drewnotdrew/digital-gate-driver/documentation/images/2025-04-20_17-02.png

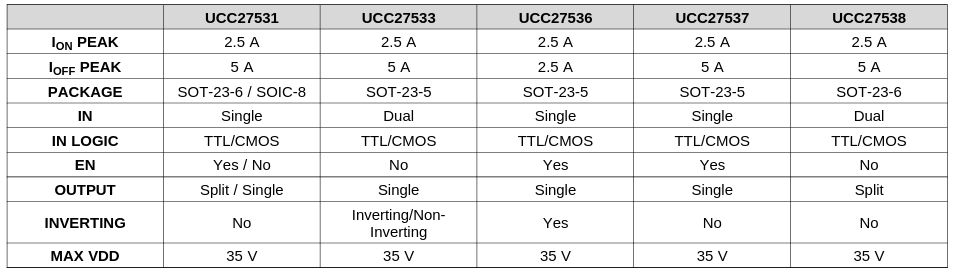
documentation/images/2025-04-20_17-02.png
