drewnotdrew/digital-gate-driver/documentation/images/2025-04-20_17-09.png

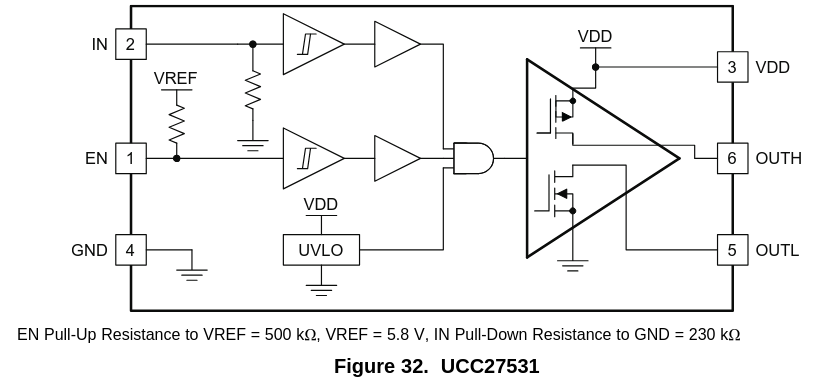
documentation/images/2025-04-20_17-09.png
