drewnotdrew/digital-gate-driver/documentation/images/digital-gate-driver-block-diagram.png

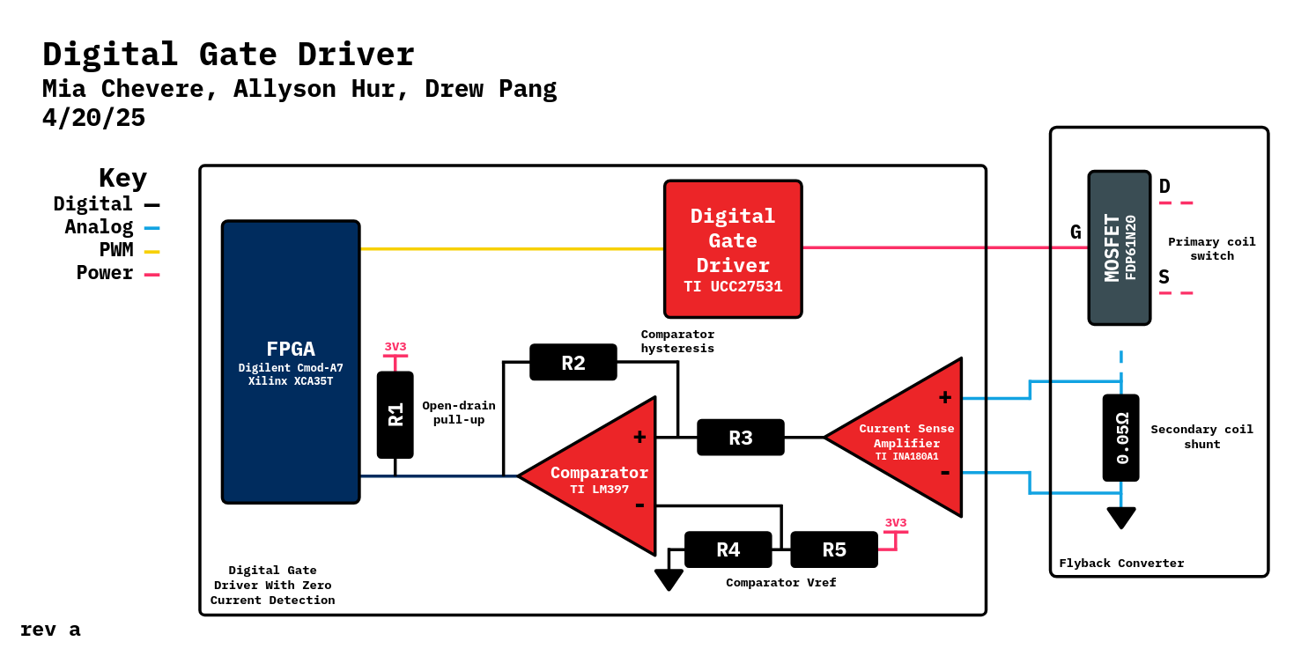
documentation/images/digital-gate-driver-block-diagram.png
