drewnotdrew/digital-gate-driver/pcb/digital_gate_driver.dxf

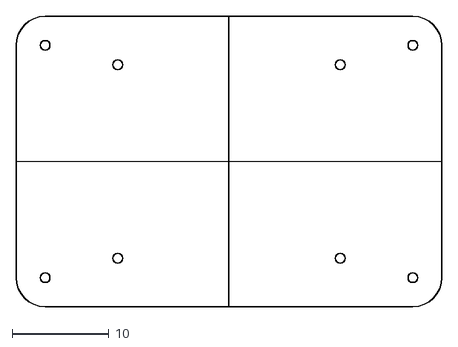
[picture p7: CAD file, 2025-04-23]
pcb/digital_gate_driver.dxf
44.0 x 30.0
