drewnotdrew/digital-gate-driver/pcb/digital-gate-driver.pdf

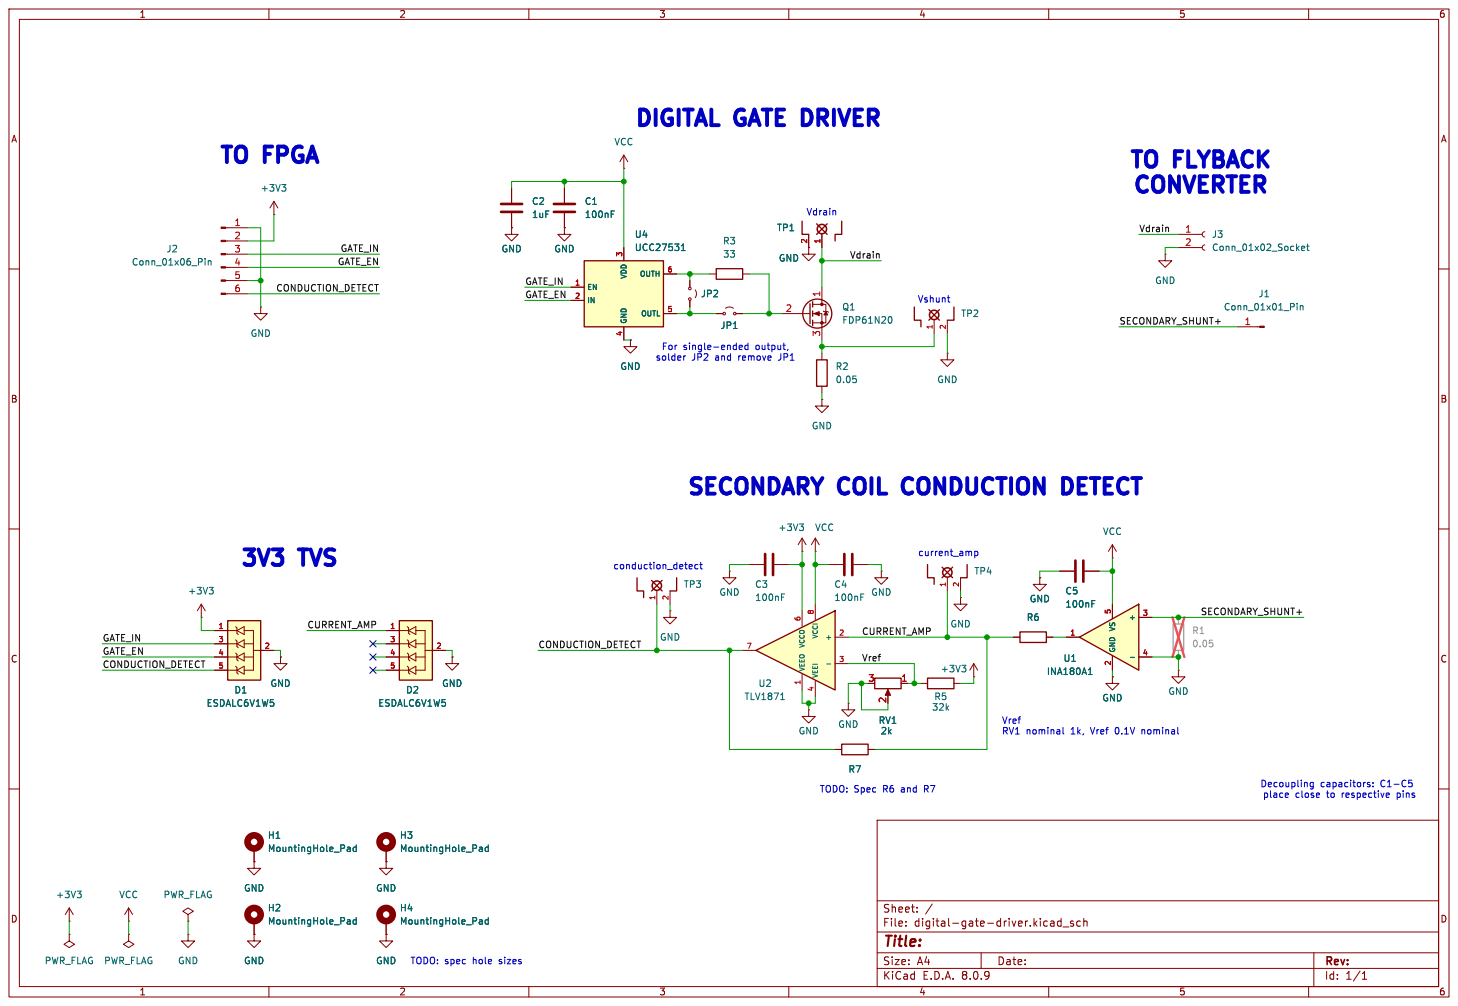
[picture p8: page 1]

4 OUTL 5 OUTH 6 U4 UCC27531 GND GND

4 OUTL 5 OUTH 6 GND GND
