drewnotdrew/digital-gate-driver/pcb/digital-gate-driver.kicad_pcb

## KiCad design pcb/digital-gate-driver.kicad_pcb (2025-04-23)

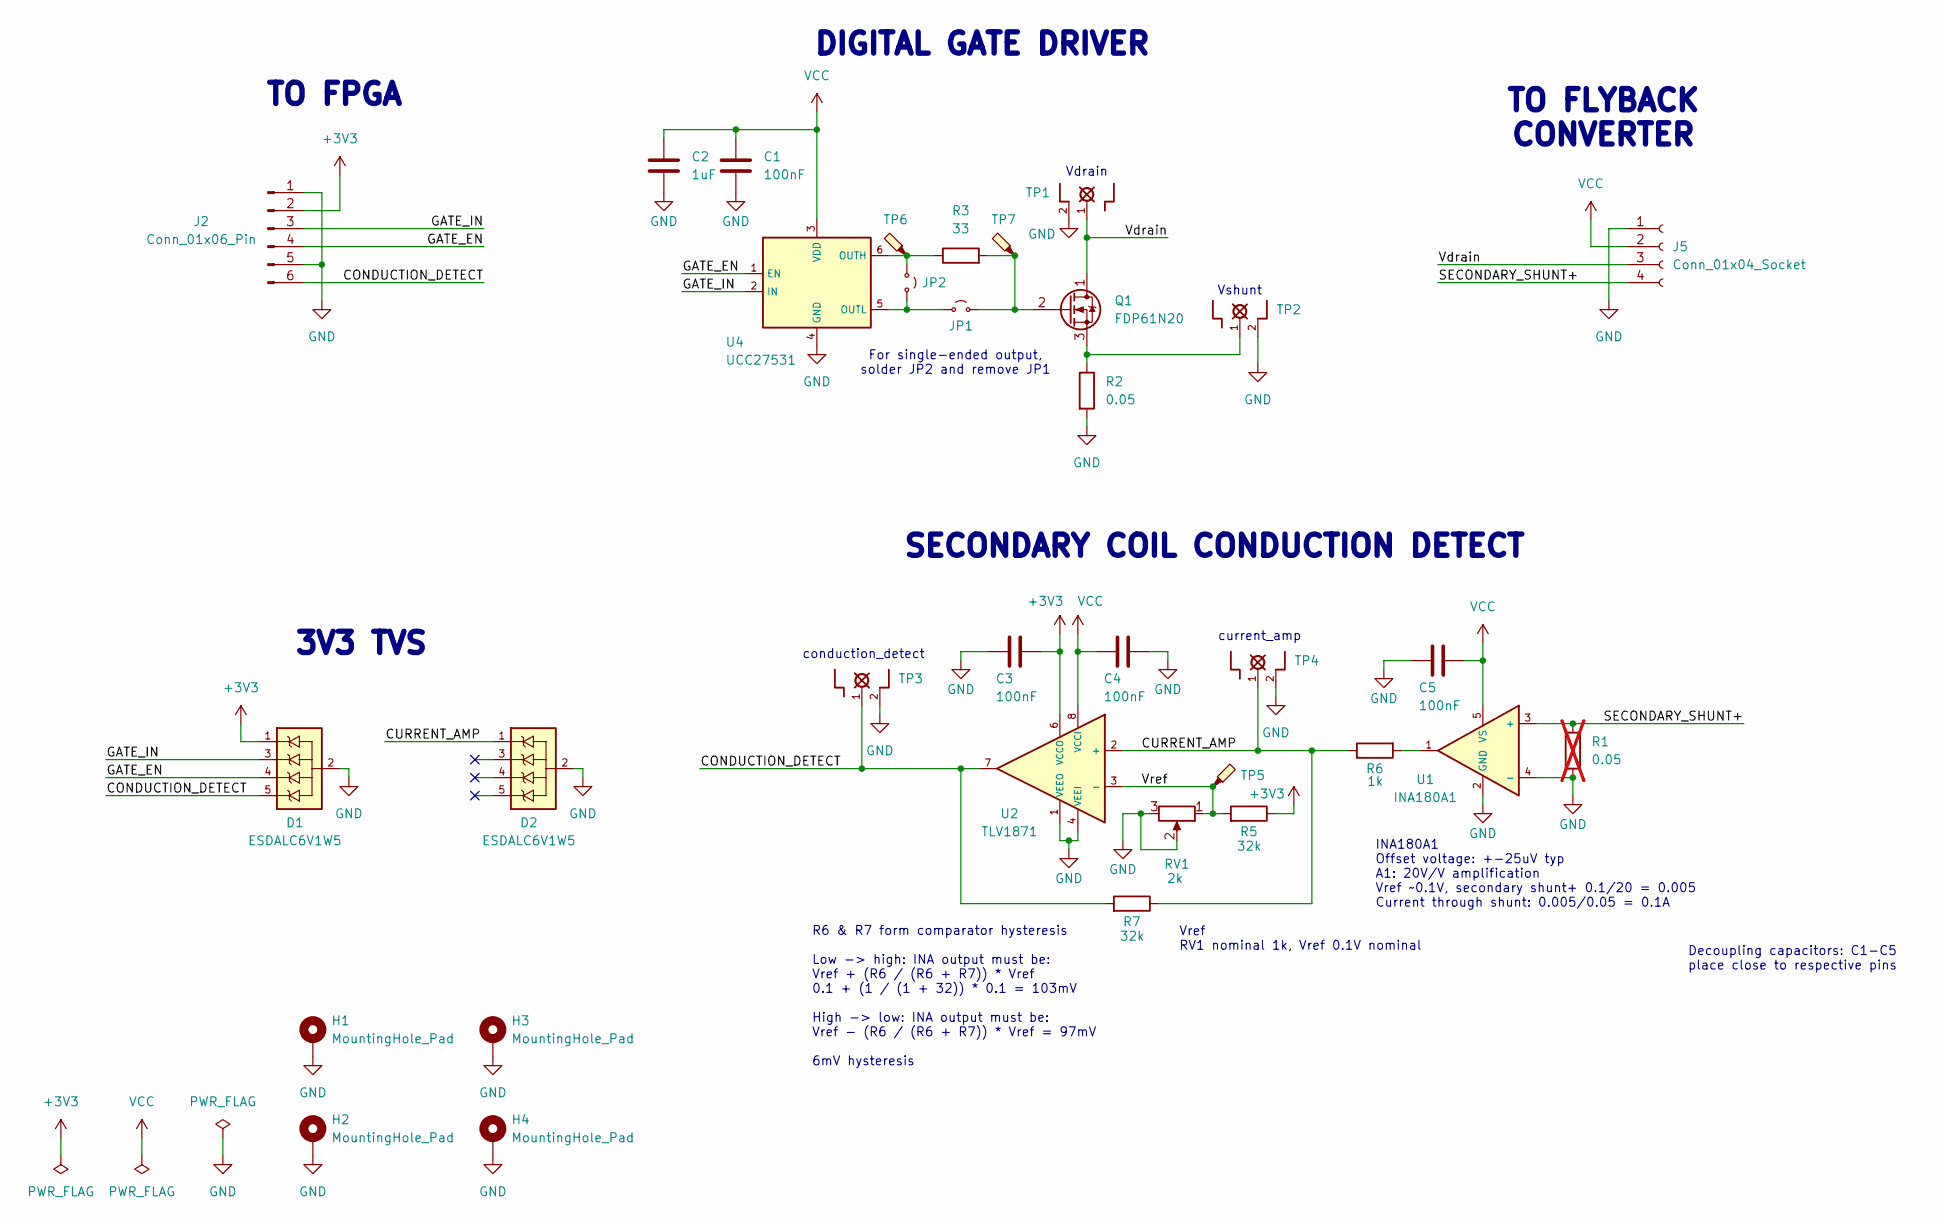
[picture p9: schematic digital-gate-driver.kicad_sch]

Parts:
C1, C3, C4, C5: 100nF; C_0603_1608Metric
C2: 1uF; C_0603_1608Metric
D1, D2: ESDALC6V1W5; MPN ESDALC6V1W5
H1, H2, H3, H4: MountingHole_Pad; MountingHole_2.5mm_Pad_Via
J2: Conn_01x06_Pin; PinHeader_1x06_P2.54mm_Vertical
J5: Conn_01x04_Socket; MOLEX_436500418
JP1, JP2: Jumper_2_Small_Open; SolderJumper-2_Open_Hooks0.8x1.8mm
Q1: FDP61N20; MPN FDP61N20
R1: 0.05; R_1206_3216Metric; not fitted
R2: 0.05; R_1206_3216Metric
R3: 33; THT_SOCKET_RESISTOR
R5, R7: 32k; R_0603_1608Metric
R6: 1k; R_0603_1608Metric
RV1: 2k; PV36W201C01B00
TP1, TP2, TP3, TP4: TP_SCOPE
TP5, TP6, TP7: TestPoint_Probe; TP_SMD
U1: INA180A1; INA180A1IDBVR; MPN INA180A1IDBVR
U2: TLV1871; TLV1871DDFR; MPN TLV1871DDFR
U4: UCC27531; UCC2753DBVT; MPN UCC27531DBVR

Connections:
+3V3: C3.2, D1.1, J2.2, R5.1, U2.6 (VCCO)
/CONDUCTION_DETECT: D1.5, J2.6, R7.2, TP3.1, U2.7
/CURRENT_AMP: D2.1, R6.1, R7.1, TP4.1, U2.2 (+)
/GATE_EN: D1.4, J2.4, U4.1 (EN)
/GATE_IN: D1.3, J2.3, U4.2 (IN)
/SECONDARY_SHUNT+: J5.4, R1.1, U1.3 (+)
/Vdrain: J5.3, Q1.1 (D), TP1.1
/Vref: R5.2, RV1.1, TP5.1, U2.3 (-)
GND: C1.2, C2.2, C3.1, C4.2, C5.1, D1.2, D2.2, H1.1, H2.1, H3.1, H4.1, J2.1, J2.5, J5.1, R1.2, R2.2, RV1.2, RV1.3, TP1.2, TP2.2, TP3.2, TP4.2, U1.2 (GND), U1.4 (-), U2.1 (VEEO), U2.4 (VEEI), U4.4 (GND)
unnamed: JP1.1 (A), JP2.2 (B), U4.5 (OUTL)
unnamed: JP1.2 (B), Q1.2 (G), R3.2, TP7.1
unnamed: JP2.1 (A), R3.1, TP6.1, U4.6 (OUTH)
unnamed: Q1.3 (S), R2.1, TP2.1
unnamed: R6.2, U1.1
VCC: C1.1, C2.1, C4.1, C5.2, J5.2, U1.5 (VS), U2.8 (VCCI), U4.3 (VDD)

Notes on the sheet:
conduction_detect
Decoupling capacitors: C1-C5 place close to respective pins
TO FLYBACK CONVERTER
3V3 TVS
For single-ended output, solder JP2 and remove JP1
DIGITAL GATE DRIVER
INA180A1 Offset voltage: +-25uV typ A1: 20V/V amplification Vref ~0.1V, secondary shunt+ 0.1/20 = 0.005 Current through shunt: 0.005/0.05 = 0.1A
Vref RV1 nominal 1k, Vref 0.1V nominal
Vshunt
R6 & R7 form comparator hysteresis Low -> high: INA output must be: Vref + (R6 / (R6 + R7)) * Vref 0.1 + (1 / (1 + 32)) * 0.1 = 103mV High -> low: INA output must be: Vref - (R6 / (R6 + R7)) * Vref = 97mV 6mV hysteresis
SECONDARY COIL CONDUCTION DETECT
current_amp
Vdrain
TO FPGA

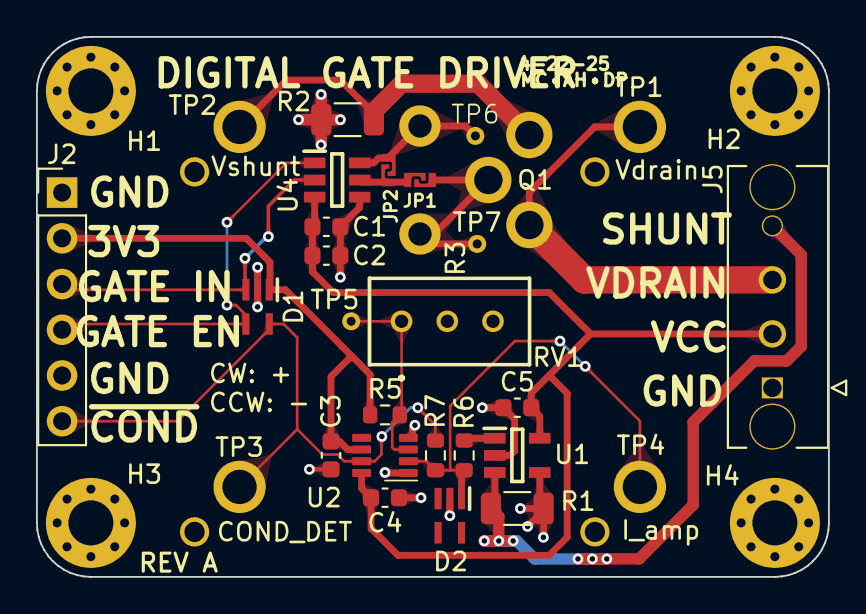
[picture p10: board digital-gate-driver.kicad_pcb from above]

Board: 2 copper layers, 44.0 x 30.0 mm, 33 parts (0 on the bottom side), 15 nets.
