drewnotdrew/digital-gate-driver/fpga/hdl/interfaces/uart/uart.sv

/*
Full-duplex uart interface with parameterized synchronization and oversampling.

The input synchronizer and oversampling form the input buffer, which directly
samples rx. The rx buffer is filled using majority voting based on the
oversampling poriton of the input buffer.

The input buffer is centered, meaning that the halfway through a UART bit the
input buffer is half full.

@param BUFFER_WIDTH: The number of data bits in a transmission
@param BAUD_RATE: The number of bits per second
@param CLK_FREQ: The input module clock frequency
@param SYNC_DEPTH: The depth of the input syncronyizer
@param OVERSAMPLING_DEPTH: The number of samples to take for each bit. Care must be
  taken to ensure the amount of oversampling does conflict with the baud rate.

*/

`begin_keywords "1800-2017"  // Use SystemVerilog 2017 keywords
`default_nettype none

module uart 
#(
  parameter BUFFER_WIDTH = 8,
  parameter BAUD_RATE = 115_200,
  parameter CLK_FREQ = 125_000_000,
  parameter SYNC_DEPTH = 3,
  parameter OVERSAMPLING_DEPTH = 4
)
(
  input wire rst_n,
  input wire clk,

  // uart rx
  input  wire  rx,
  output logic [BUFFER_WIDTH-1:0] read_data,
  input  wire  read_ready,
  output logic read_valid,

  // uart tx
  output logic tx,
  // output logic tx_done,
  input  wire  [BUFFER_WIDTH-1:0] write_data,
  input  wire  write_valid,
  output logic write_ready
);
  timeunit 1ns; timeprecision 100ps;

  // local parameters
  localparam BUFFER_COUNTER_BITS = $clog2(BUFFER_WIDTH);
  localparam CLK_CYCLES_PER_BIT = CLK_FREQ / BAUD_RATE;
  localparam CLK_CYCLE_COUNTER_BITS = $clog2(CLK_CYCLES_PER_BIT);
  localparam INPUT_BUFFER_WIDTH = SYNC_DEPTH + OVERSAMPLING_DEPTH;
  // determines when to sample, ensures input buffer is centered
  localparam [CLK_CYCLE_COUNTER_BITS-1:0] CLK_CYCLES_TILL_SAMPLE = (CLK_CYCLE_COUNTER_BITS)'((CLK_CYCLES_PER_BIT + INPUT_BUFFER_WIDTH) / 2);
  localparam [CLK_CYCLE_COUNTER_BITS-1:0] CLK_CYCLES_AFTER_SAMPLE = (CLK_CYCLE_COUNTER_BITS)'((CLK_CYCLES_PER_BIT - INPUT_BUFFER_WIDTH) / 2);
  localparam [CLK_CYCLE_COUNTER_BITS-1:0] CLK_CYCLES_PER_HALF_BIT = (CLK_CYCLE_COUNTER_BITS)'(CLK_CYCLES_PER_BIT/2);
  localparam OVERSAMPLING_DEPTH_BITS = $clog2(OVERSAMPLING_DEPTH);

  // uart read states
  typedef enum logic [4:0] {
    RX_RESET = 5'b00000,
    RX_IDLE  = 5'b00001,
    RX_START = 5'b00010,
    RX_READ  = 5'b00100,
    RX_STOP  = 5'b01000,
    RX_ERROR = 5'b10000
  } uart_rx_state_t;

  // uart write states
  typedef enum logic [4:0] {
    TX_RESET = 5'b00000,
    TX_IDLE  = 5'b00001,
    TX_START = 5'b00010,
    TX_WRITE = 5'b00100,
    TX_STOP  = 5'b01000,
    TX_ERROR = 5'b10000
  } uart_tx_state_t;

/* 
 * =======================================
 * Receive
 * =======================================
 */

  // internal rx variables
  uart_rx_state_t rx_state, rx_next_state;
  logic [BUFFER_COUNTER_BITS:0] rx_bit_counter;
  logic [CLK_CYCLE_COUNTER_BITS-1:0] rx_clk_counter;
  logic input_shift_en, input_sample, rx_shift_en, rx_bit_counter_rst_n, rx_clk_counter_rst_n, rx_post_reset;
  logic [INPUT_BUFFER_WIDTH-1:0] input_buffer;

  // rx current state logic
  always_ff @( posedge clk ) begin : _rx_current_state_logic
    if (!rst_n)
      rx_state <= RX_RESET;
    else 
      rx_state <= rx_next_state;
  end

  // rx next state logic
  always_comb begin : _rx_next_state_logic
    unique case (rx_state)
      RX_RESET:
        rx_next_state = RX_IDLE;
      RX_IDLE:
        if (rx_negative_edge)
          rx_next_state = RX_START;
        else
          rx_next_state = RX_IDLE;
      RX_START:
        if (rx_clk_counter == '0)
          rx_next_state = RX_READ;
        else
          rx_next_state = RX_START;
      RX_READ:
        if (rx_bit_counter  == '0)
          rx_next_state = RX_STOP;
        else
          rx_next_state = RX_READ;
      RX_STOP:
        if (rx_clk_counter  == CLK_CYCLES_PER_HALF_BIT)
          rx_next_state = RX_IDLE;
        else
          rx_next_state = RX_STOP;
      RX_ERROR:
        rx_next_state = RX_ERROR;
      default:
        rx_next_state = RX_ERROR; // catch glitches
    endcase
  end

  // rx fsm outputs
  always_comb begin : _rx_fsm_outputs
    unique case (rx_state)
      RX_RESET, RX_ERROR: begin
        {rx_shift_en, read_valid, rx_post_reset} = 3'b001; // todo: rx_post_rest inferred as a latch
        {rx_clk_counter_rst_n, rx_bit_counter_rst_n} = 2'b00;
      end
      RX_IDLE: begin
        if (rx_post_reset)
          {rx_shift_en, read_valid, rx_post_reset} = 3'b001;
        else
          {rx_shift_en, read_valid, rx_post_reset} = 3'b010;
        {rx_clk_counter_rst_n, rx_bit_counter_rst_n} = 2'b00;
      end
      RX_START: begin
        {rx_shift_en, read_valid, rx_post_reset} = 3'b000;
        {rx_clk_counter_rst_n, rx_bit_counter_rst_n} = 2'b10;
      end
      RX_READ: begin
        {rx_shift_en, read_valid, rx_post_reset} = 3'b100;
        {rx_clk_counter_rst_n, rx_bit_counter_rst_n} = 2'b11;
      end
      RX_STOP: begin
        {rx_shift_en, read_valid, rx_post_reset} = 3'b010;
        {rx_clk_counter_rst_n, rx_bit_counter_rst_n} = 2'b10;
      end
      default: begin 
        {rx_shift_en, read_valid, rx_post_reset} = 3'b000;
        {rx_clk_counter_rst_n, rx_bit_counter_rst_n} = 2'b00;
      end
    endcase
  end

  // input shift register, for synchronization and oversampling
  always_ff @( posedge clk ) begin : _input_shift_register
    if (!rst_n)
      input_buffer <= '0;
    else //if (input_shift_en)
      input_buffer <= {rx, input_buffer[INPUT_BUFFER_WIDTH-1:1]}; // lsb first
    // else
    //   input_buffer <= input_buffer;
  end

  // rx negative edge detector
  logic rx_negative_edge;
  assign rx_negative_edge = !input_buffer[OVERSAMPLING_DEPTH] & input_buffer[OVERSAMPLING_DEPTH - 1];

  // oversample count
  logic [OVERSAMPLING_DEPTH_BITS:0] oversample_ones_count; 
  count_ones #(
    .N(OVERSAMPLING_DEPTH)
  ) 
  count_oversample_ones (
    .data(input_buffer[OVERSAMPLING_DEPTH-1:0]),
    .count(oversample_ones_count)
  );

  // sample based on oversample majority vote count
  assign input_sample = (oversample_ones_count) >= (OVERSAMPLING_DEPTH_BITS+1)'(OVERSAMPLING_DEPTH / 2);

  // rx shift register
  always_ff @( posedge clk ) begin : _rx_shift_register
    if (!rst_n)
      read_data <= '0;
    else if (rx_shift_en && rx_clk_counter == CLK_CYCLES_AFTER_SAMPLE)
      read_data <= {input_sample, read_data[BUFFER_WIDTH-1:1]}; // lsb first
    else
      read_data <= read_data;
  end

  // rx bit counter
  always_ff @( posedge clk ) begin : _rx_bit_counter
    if (!rx_bit_counter_rst_n)
      rx_bit_counter <= (BUFFER_COUNTER_BITS + 1)'(BUFFER_WIDTH);
    else if (rx_bit_counter == '0)
      rx_bit_counter <= (BUFFER_COUNTER_BITS + 1)'(BUFFER_WIDTH);
    else if (rx_clk_counter == CLK_CYCLES_AFTER_SAMPLE)
      rx_bit_counter <= rx_bit_counter - 1;
  end

  // rx clock cycle counter
  always_ff @( posedge clk ) begin : _rx_clock_cycle_counter
    if (!rx_clk_counter_rst_n) begin
      rx_clk_counter <= CLK_CYCLE_COUNTER_BITS'(CLK_CYCLES_PER_BIT - 1);
    end else if (rx_clk_counter == '0) begin
      rx_clk_counter <= CLK_CYCLE_COUNTER_BITS'(CLK_CYCLES_PER_BIT - 1);
    end else begin
      rx_clk_counter <= rx_clk_counter - 1;
    end
  end

/* 
 * =======================================
 * Transmit
 * =======================================
 */

  // internal tx variables
  uart_tx_state_t tx_state, tx_next_state;
  logic [BUFFER_COUNTER_BITS:0] tx_bit_counter;
  logic [CLK_CYCLE_COUNTER_BITS-1:0] tx_clk_counter;
  logic tx_shift_en, tx_bit_counter_rst_n, tx_clk_counter_rst_n;

  // tx current state logic
  always_ff @( posedge clk ) begin : _tx_current_state_logic
    if (!rst_n)
      tx_state <= TX_RESET;
    else 
      tx_state <= tx_next_state;
  end

  // tx next state logic
  always_comb begin : _tx_next_state_logic
    unique case (tx_state)
      TX_RESET:
        tx_next_state = TX_IDLE;
      TX_IDLE:
        if (write_valid)
          tx_next_state = TX_START;
        else
          tx_next_state = TX_IDLE;
      TX_START:
        if (tx_clk_counter == '0)
          tx_next_state = TX_WRITE;
        else
          tx_next_state = TX_START;
      TX_WRITE:
        if (tx_bit_counter  == '0)
          tx_next_state = TX_STOP;
        else
          tx_next_state = TX_WRITE;
      TX_STOP:
        if (tx_clk_counter  == CLK_CYCLES_PER_HALF_BIT)
          tx_next_state = TX_IDLE;
        else
          tx_next_state = TX_STOP;
      TX_ERROR:
        tx_next_state = TX_ERROR;
      default:
        tx_next_state = TX_ERROR; // catch glitches
    endcase
  end

  // tx fsm outputs
  always_comb begin : _tx_fsm_outputs
    unique case (tx_state)
      TX_RESET, TX_ERROR: begin
        {tx_shift_en, write_ready} = 2'b00;
        {tx_clk_counter_rst_n, tx_bit_counter_rst_n} = 2'b00;
      end
      TX_IDLE: begin
        {tx_shift_en, write_ready} = 2'b01;
        {tx_clk_counter_rst_n, tx_bit_counter_rst_n} = 2'b00;
      end
      TX_START: begin
        {tx_shift_en, write_ready} = 2'b00;
        {tx_clk_counter_rst_n, tx_bit_counter_rst_n} = 2'b10;
      end
      TX_WRITE: begin
        {tx_shift_en, write_ready} = 2'b10;
        {tx_clk_counter_rst_n, tx_bit_counter_rst_n} = 2'b11;
      end
      TX_STOP: begin
        {tx_shift_en, write_ready} = 2'b00;
        {tx_clk_counter_rst_n, tx_bit_counter_rst_n} = 2'b10;
      end
      default: begin 
        {tx_shift_en, write_ready} = 2'b00;
        {tx_clk_counter_rst_n, tx_bit_counter_rst_n} = 2'b00;
      end
    endcase
  end

  // tx shift register
  always_ff @( posedge clk ) begin : _tx_shift_register
    if (!rst_n)
      tx <= '1;
    else if (tx_next_state == TX_IDLE)
      // Potentially sketchy. Cycle steal to prevent glitches on tx
      tx <= '1;
    else if (tx_state == TX_START)
      tx <= '0;
    else if (tx_shift_en)
      tx <= write_data[BUFFER_WIDTH - tx_bit_counter]; // lsb first
    else
      tx <= '1;
  end

  // tx bit counter
  always_ff @( posedge clk ) begin : _tx_bit_counter
    if (!tx_bit_counter_rst_n)
      tx_bit_counter <= (BUFFER_COUNTER_BITS + 1)'(BUFFER_WIDTH);
    else if (tx_bit_counter == '0)
      tx_bit_counter <= (BUFFER_COUNTER_BITS + 1)'(BUFFER_WIDTH);
    else if (tx_clk_counter == '0)
      tx_bit_counter <= tx_bit_counter - 1;
  end

  // tx clock cycle counter
  always_ff @( posedge clk ) begin : _tx_clock_cycle_counter
    if (!tx_clk_counter_rst_n) begin
      tx_clk_counter <= CLK_CYCLE_COUNTER_BITS'(CLK_CYCLES_PER_BIT - 1);
    end else if (tx_clk_counter == '0) begin
      tx_clk_counter <= CLK_CYCLE_COUNTER_BITS'(CLK_CYCLES_PER_BIT - 1);
    end else begin
      tx_clk_counter <= tx_clk_counter - 1;
    end
  end

endmodule : uart

`default_nettype wire 
`end_keywords
