drewnotdrew/digital-gate-driver/(commit log)

2025-04-19 setup env, add uart ip
2025-04-19 add blank dgd pcb
    [digital-gate-driver.kicad_pcb, digital-gate-driver.kicad_sch]
2025-04-20 organize files
    [digital-gate-driver.kicad_pcb, digital-gate-driver.kicad_sch]
2025-04-20 add dgd selection documentation
    [lab3_9v_gate.csv]
2025-04-21 complete base schematic
    [digital-gate-driver.kicad_sch]
2025-04-21 complete schematic, assign all fp
    [digital-gate-driver.kicad_pcb, digital-gate-driver.kicad_sch]
2025-04-21 update header fp
    [digital-gate-driver.kicad_pcb, digital-gate-driver.kicad_sch]
2025-04-21 update shunt resistor sizes
    [digital-gate-driver.kicad_pcb, digital-gate-driver.kicad_sch]
2025-04-22 add all footprints
    [digital-gate-driver.kicad_pcb, digital-gate-driver.kicad_sch]
2025-04-23 complete layout
    [digital-gate-driver.kicad_pcb, digital-gate-driver.kicad_sch, digital_gate_driver.dxf]
2025-04-23 spec hysteresis resistors, update socket hole diameters
    [digital-gate-driver.kicad_pcb, digital-gate-driver.kicad_sch]
2025-04-23 add fab files
    [digital-gate-driver-B_Cu.gbl, digital-gate-driver-B_Mask.gbs, digital-gate-driver-B_Paste.gbp, digital-gate-driver-B_Silkscreen.gbo, digital-gate-driver-Edge_Cuts.gm1, digital-gate-driver-F_Cu.gtl, digital-gate-driver-F_Mask.gts, digital-gate-driver-F_Paste.gtp]
2025-04-23 add final fab files
    [digital-gate-driver-B_Cu.gbl, digital-gate-driver-B_Mask.gbs, digital-gate-driver-B_Paste.gbp, digital-gate-driver-B_Silkscreen.gbo, digital-gate-driver-Edge_Cuts.gm1, digital-gate-driver-F_Cu.gtl, digital-gate-driver-F_Mask.gts, digital-gate-driver-F_Paste.gtp]
2025-04-27 Fix makefile and add starter files
    [main.sv, pwm.sv]
2025-05-02 Add pwm testbench files
2025-05-02 Add pwm module
2025-05-02 debug pwm
2025-05-02 Edit pwm module
2025-05-02 Finalize PWM module
